tomstdenis/buck85/gerber/002/board.png

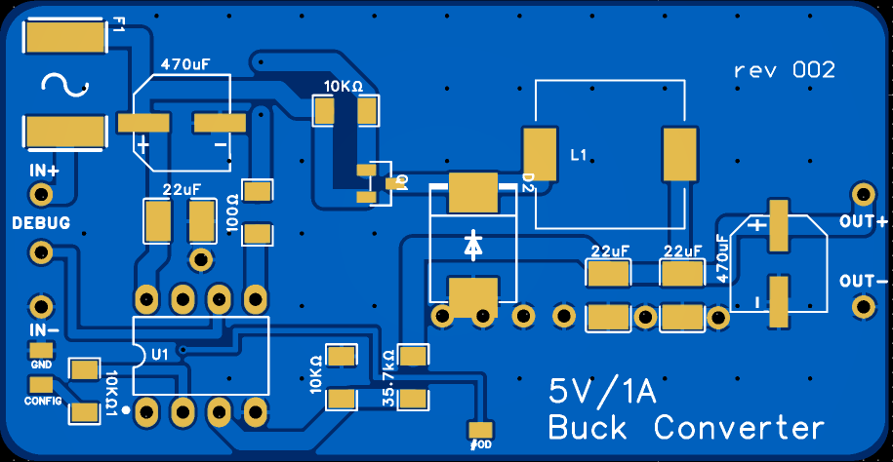
gerber/002/board.png
