tomstdenis/buck85/(commit log)

2025-12-13 rev 001 gerber order
    [Drill_PTH_Through.DRL, Drill_PTH_Through_Via.DRL, Gerber_BoardOutlineLayer.GKO, Gerber_BottomLayer.GBL, Gerber_BottomSilkscreenLayer.GBO, Gerber_BottomSolderMaskLayer.GBS, Gerber_TopLayer.GTL, Gerber_TopPasteMaskLayer.GTP]
2025-12-14 reset integral when switching modes
    [buck85.ino]
2025-12-14 fix serial output, use correct pin for ADC input, remove delay(1000) from fault state
    [buck85.ino]
2025-12-14 more debugging, also recover from CONFIG_SENSE failure without rebooting
    [buck85.ino]
2025-12-14 add more baud rates and fix SENSE mode where noise from the Timer/PWM was influencing the reading somehow...
    [buck85.ino]
2025-12-14 fix delay due to prescaler
    [buck85.ino]
2025-12-19 attempt more stable ADC reads
2025-12-19 move gerber to 001 directory and add a board photo
    [Drill_PTH_Through.DRL, Drill_PTH_Through_Via.DRL, Gerber_BoardOutlineLayer.GKO, Gerber_BottomLayer.GBL, Gerber_BottomSilkscreenLayer.GBO, Gerber_BottomSolderMaskLayer.GBS, Gerber_TopLayer.GTL, Gerber_TopPasteMaskLayer.GTP]
2025-12-19 fine grained pwm update
2025-12-21 add optional Timer1 mode for 62.5KHz PWM
2025-12-21 fix PWM when in sense mode, reset floor to 0% PWM, don't reset nl history on overshoot
    [buck85.ino]
2025-12-21 make over/under correction proportional with a 16 code dead zone, now the AC ripple is PWM frequency and around 20mV at 150mA load
    [buck85.ino]
2025-12-21 add options for TIMER1 frequency
2025-12-21 cleanup Timer1 support a bit more
